DevLaTron/sd2snes/pcb/kicad/RevK/fpga.sch

## KiCad design pcb/kicad/RevK/fpga.sch (2018-12-27)

Schematic: fpga.sch

Parts:
C201, C202, C203, C204, C205, C206, C207, C208, C209, C210, C211, C212, C213, C214, C215, C221, C222, C223, C224, C231, C232, C233, C234: 100n; SM0805_FIXEDMASK
P113: CONN_1; PAD_1x1mm
U201: XC3S400-PQ208; PQFP208_ALTPADS

Notes on the sheet:
FPGA
SNES A+B bus
70ns PSRAM bus
45ns SRAM bus
SD bus; shared with MCU
SPI (MCU interface)
DAC
JTAG
