DevLaTron/sd2snes/pcb/kicad/RevK/pwr_misc.sch

## KiCad design pcb/kicad/RevK/pwr_misc.sch (2018-12-27)

Schematic: pwr_misc.sch

Parts:
BT351: Keystone 1059 / KZH20PCB; BT_KEYSTONE_1059_20MM
C301, C303, C304, C311, C312, C321, C322: 4.7u; SM0805_FIXEDMASK
C302: 10n; SM0805_FIXEDMASK
C331, C341, C343: 100n; SM0805_FIXEDMASK
C332, C333: 100p; SM0805_FIXEDMASK
C342: 1u; SM0805_FIXEDMASK
C344, C345: 10u; SM0805_FIXEDMASK
C391: 100u; SM1210L
FB341: FILTER; SM0805_FIXEDMASK
JP341: FB 0603; SolderJumper-2_P1.3mm_Open_Pad1.0x1.5mm
L301, L302: 1uH; SM1210L; PartNo LQH32PN1R0NN0L
L391: 10uH; SM1210L
Q301: IRLML6402PbF; SOT-23
R230, R231: 10; SM0805_FIXEDMASK
R301: 20k; SM0805_FIXEDMASK
R331, R332, R333: 680; SM0805_FIXEDMASK
U230: TS9222; TSSOP-8_4.4x3mm_P0.65mm
U301: MIC23250-S4YMT; QFN10-2x2
U311: MCP1824-1802E/OT; SOT23-5_LARGEPADS
U321: MCP1824-2502E/OT; SOT23-5_LARGEPADS
U331: PIC12F629-I/P; DIP-8_W7.62mm
U341: CS4344; TSSOP10

Notes on the sheet:
Stuff with 0603 ferrite bead
Power, DAC, CIC, Batt
inverse polarity protection
Battery (SRAM + RTC)
2.5V LDO
1.8V LDO
3.3V + 1.2V Step-Down
Audio DAC
Power Supply
SuperCIC Key
