DevLaTron/sd2snes/pcb/kicad/RevK/snesslot.sch

## KiCad design pcb/kicad/RevK/snesslot.sch (2019-01-02, an earlier design)

Schematic: snesslot.sch

Parts:
C101, C102, C103, C104, C105, C106, C111, C112, C113, C114, C115, C116: 100n; SM0805_FIXEDMASK
C121, C122, C123, C124, C125, C126, C127, C128: 10p; SM0805_FIXEDMASK
J101: SNESCART_EXT
Q101: 2N2222A; SOT-23-EBC
R101: 270; SM0805_FIXEDMASK
R102: 100k; SM0805_FIXEDMASK
R103: 4k7; SM0805_FIXEDMASK
RA101, RA102, RA105, RA106, RA107, RA108, RA109, RA110, RA111, RA112, RA113, RA114: 100; R_PACK_1206_2
RA103, RA104: FB; R_PACK_1206_2
U101, U102, U103: 74ALVC164245DGG; TSSOP48

Notes on the sheet:
SNES bus, level shift
