DevLaTron/sd2snes/pcb/kicad/RevK/rescue-backup/pwr_misc-2018-12-25-14-31-40.sch

## KiCad design pcb/kicad/RevK/rescue-backup/pwr_misc-2018-12-25-14-31-40.sch (2018-12-25)

Schematic: pwr_misc-2018-12-25-14-31-40.sch

Parts:
BT351: Keystone 1059 / KZH20PCB; BT_KEYSTONE_1059_20MM
C301, C303, C304, C311, C312, C321, C322: 4.7u; SM0805_FIXEDMASK
C302, C347, C349: 10n; SM0805_FIXEDMASK
C331, C341, C343: 100n; SM0805_FIXEDMASK
C332, C333: 100p; SM0805_FIXEDMASK
C342: 1u; SM0805_FIXEDMASK
C344, C345: 10u; SM0805_FIXEDMASK
C346, C348: 3.3u; SM0805_FIXEDMASK
C391: 100u
FB341: FILTER
JP341: FB 0603
L301, L302: 1uH; SM1210L; PartNo LQH32PN1R0NN0L
L391: 10uH
Q301: IRLML6402PbF
R301: 20k; SM0805_FIXEDMASK
R331, R332, R333: 680; SM0805_FIXEDMASK
R341, R343: 470; SM0805_FIXEDMASK
R342, R344: 10k; SM0805_FIXEDMASK
U301: MIC23250-S4YMT; QFN10-2x2
U311: MCP1824-1802E/OT; SOT23-5
U321: MCP1824-2502E/OT; SOT23-5
U331: PIC12F629-I/P; SO8N
U341: CS4344; TSSOP10

Notes on the sheet:
Stuff with 0603 ferrite bead
Power, DAC, CIC, Batt
inverse polarity protection
Battery (SRAM + RTC)
2.5V LDO
1.8V LDO
3.3V + 1.2V Step-Down
Audio DAC
Power Supply
SuperCIC Key
