DevLaTron/sd2snes/verilog/sd2snes_gsu/ipcore_dir/gsu_fmult.v

////////////////////////////////////////////////////////////////////////////////
// Copyright (c) 1995-2013 Xilinx, Inc.  All rights reserved.
////////////////////////////////////////////////////////////////////////////////
//   ____  ____
//  /   /\/   /
// /___/  \  /    Vendor: Xilinx
// \   \   \/     Version: P.20131013
//  \   \         Application: netgen
//  /   /         Filename: gsu_fmult.v
// /___/   /\     Timestamp: Thu Jun 07 01:15:08 2018
// \   \  /  \ 
//  \___\/\___\
//             
// Command	: -w -sim -ofmt verilog D:/prj/sd2snes/verilog/sd2snes_gsu/ipcore_dir/tmp/_cg/gsu_fmult.ngc D:/prj/sd2snes/verilog/sd2snes_gsu/ipcore_dir/tmp/_cg/gsu_fmult.v 
// Device	: 3s400pq208-4
// Input file	: D:/prj/sd2snes/verilog/sd2snes_gsu/ipcore_dir/tmp/_cg/gsu_fmult.ngc
// Output file	: D:/prj/sd2snes/verilog/sd2snes_gsu/ipcore_dir/tmp/_cg/gsu_fmult.v
// # of Modules	: 1
// Design Name	: gsu_fmult
// Xilinx        : E:\Xilinx\14.7\ISE_DS\ISE\
//             
// Purpose:    
//     This verilog netlist is a verification model and uses simulation 
//     primitives which may not represent the true implementation of the 
//     device, however the netlist is functionally correct and should not 
//     be modified. This file cannot be synthesized and should only be used 
//     with supported simulation tools.
//             
// Reference:  
//     Command Line Tools User Guide, Chapter 23 and Synthesis and Simulation Design Guide, Chapter 6
//             
////////////////////////////////////////////////////////////////////////////////

`timescale 1 ns/1 ps

module gsu_fmult (
  clk, p, a, b
)/* synthesis syn_black_box syn_noprune=1 */;
  input clk;
  output [31 : 0] p;
  input [15 : 0] a;
  input [15 : 0] b;
  
  // synthesis translate_off
  
  wire \blk00000001/sig00000043 ;
  wire \blk00000001/sig00000042 ;
  wire \blk00000001/sig00000041 ;
  wire \blk00000001/sig00000040 ;
  wire \blk00000001/sig0000003f ;
  wire \blk00000001/sig0000003e ;
  wire \blk00000001/sig0000003d ;
  wire \blk00000001/sig0000003c ;
  wire \blk00000001/sig0000003b ;
  wire \blk00000001/sig0000003a ;
  wire \blk00000001/sig00000039 ;
  wire \blk00000001/sig00000038 ;
  wire \blk00000001/sig00000037 ;
  wire \blk00000001/sig00000036 ;
  wire \blk00000001/sig00000035 ;
  wire \blk00000001/sig00000034 ;
  wire \blk00000001/sig00000033 ;
  wire \blk00000001/sig00000032 ;
  wire \blk00000001/sig00000031 ;
  wire \blk00000001/sig00000030 ;
  wire \blk00000001/sig0000002f ;
  wire \blk00000001/sig0000002e ;
  wire \blk00000001/sig0000002d ;
  wire \blk00000001/sig0000002c ;
  wire \blk00000001/sig0000002b ;
  wire \blk00000001/sig0000002a ;
  wire \blk00000001/sig00000029 ;
  wire \blk00000001/sig00000028 ;
  wire \blk00000001/sig00000027 ;
  wire \blk00000001/sig00000026 ;
  wire \blk00000001/sig00000025 ;
  wire \blk00000001/sig00000024 ;
  wire \blk00000001/sig00000023 ;
  wire \blk00000001/sig00000022 ;
  wire \NLW_blk00000001/blk00000004_P<34>_UNCONNECTED ;
  wire \NLW_blk00000001/blk00000004_P<33>_UNCONNECTED ;
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
    .R(\blk00000001/sig00000022 ),
    .A({a[15], a[15], a[15], a[14], a[13], a[12], a[11], a[10], a[9], a[8], a[7], a[6], a[5], a[4], a[3], a[2], a[1], a[0]}),
    .B({b[15], b[15], b[15], b[14], b[13], b[12], b[11], b[10], b[9], b[8], b[7], b[6], b[5], b[4], b[3], b[2], b[1], b[0]}),
    .P({\blk00000001/sig0000003c , \NLW_blk00000001/blk00000004_P<34>_UNCONNECTED , \NLW_blk00000001/blk00000004_P<33>_UNCONNECTED , 
\NLW_blk00000001/blk00000004_P<32>_UNCONNECTED , \NLW_blk00000001/blk00000004_P<31>_UNCONNECTED , \blk00000001/sig0000003b , \blk00000001/sig00000039 
, \blk00000001/sig00000038 , \blk00000001/sig00000037 , \blk00000001/sig00000036 , \blk00000001/sig00000035 , \blk00000001/sig00000034 , 
\blk00000001/sig00000033 , \blk00000001/sig00000032 , \blk00000001/sig00000031 , \blk00000001/sig00000030 , \blk00000001/sig0000002e , 
\blk00000001/sig0000002d , \blk00000001/sig0000002c , \blk00000001/sig0000002b , \blk00000001/sig0000002a , \blk00000001/sig00000029 , 
\blk00000001/sig00000028 , \blk00000001/sig00000027 , \blk00000001/sig00000026 , \blk00000001/sig00000025 , \blk00000001/sig00000043 , 
\blk00000001/sig00000042 , \blk00000001/sig00000041 , \blk00000001/sig00000040 , \blk00000001/sig0000003f , \blk00000001/sig0000003e , 
\blk00000001/sig0000003d , \blk00000001/sig0000003a , \blk00000001/sig0000002f , \blk00000001/sig00000024 })
  );
  VCC   \blk00000001/blk00000003  (
    .P(\blk00000001/sig00000023 )
  );
  GND   \blk00000001/blk00000002  (
    .G(\blk00000001/sig00000022 )
  );

// synthesis translate_on

endmodule

// synthesis translate_off

`ifndef GLBL
`define GLBL

`timescale  1 ps / 1 ps

module glbl ();

    parameter ROC_WIDTH = 100000;
    parameter TOC_WIDTH = 0;

//--------   STARTUP Globals --------------
    wire GSR;
    wire GTS;
    wire GWE;
    wire PRLD;
    tri1 p_up_tmp;
    tri (weak1, strong0) PLL_LOCKG = p_up_tmp;

    wire PROGB_GLBL;
    wire CCLKO_GLBL;

    reg GSR_int;
    reg GTS_int;
    reg PRLD_int;

//--------   JTAG Globals --------------
    wire JTAG_TDO_GLBL;
    wire JTAG_TCK_GLBL;
    wire JTAG_TDI_GLBL;
    wire JTAG_TMS_GLBL;
    wire JTAG_TRST_GLBL;

    reg JTAG_CAPTURE_GLBL;
    reg JTAG_RESET_GLBL;
    reg JTAG_SHIFT_GLBL;
    reg JTAG_UPDATE_GLBL;
    reg JTAG_RUNTEST_GLBL;

    reg JTAG_SEL1_GLBL = 0;
    reg JTAG_SEL2_GLBL = 0 ;
    reg JTAG_SEL3_GLBL = 0;
    reg JTAG_SEL4_GLBL = 0;

    reg JTAG_USER_TDO1_GLBL = 1'bz;
    reg JTAG_USER_TDO2_GLBL = 1'bz;
    reg JTAG_USER_TDO3_GLBL = 1'bz;
    reg JTAG_USER_TDO4_GLBL = 1'bz;

    assign (weak1, weak0) GSR = GSR_int;
    assign (weak1, weak0) GTS = GTS_int;
    assign (weak1, weak0) PRLD = PRLD_int;

    initial begin
	GSR_int = 1'b1;
	PRLD_int = 1'b1;
	#(ROC_WIDTH)
	GSR_int = 1'b0;
	PRLD_int = 1'b0;
    end

    initial begin
	GTS_int = 1'b1;
	#(TOC_WIDTH)
	GTS_int = 1'b0;
    end

endmodule

`endif

// synthesis translate_on
