DevLaTron/sd2snes/verilog/sd2snes_sdd1/Input_Manager.vhd

----------------------------------------------------------------------------------
-- Company: Traducciones Magno
-- Engineer: Magno
--
-- Create Date: 18.03.2018 18:59:09
-- Design Name:
-- Module Name: Input_Manager - Behavioral
-- Project Name:
-- Target Devices:
-- Tool Versions:
-- Description:
--
-- Dependencies:
--
-- Revision:
-- Revision 0.01 - File Created
-- Additional Comments:
--
----------------------------------------------------------------------------------


library IEEE;
use IEEE.STD_LOGIC_1164.ALL;
use IEEE.STD_LOGIC_ARITH.ALL;
use IEEE.STD_LOGIC_UNSIGNED.ALL;

-- Uncomment the following library declaration if using
-- arithmetic functions with Signed or Unsigned values
use IEEE.NUMERIC_STD.ALL;

-- Uncomment the following library declaration if instantiating
-- any Xilinx leaf cells in this code.
--library UNISIM;
--use UNISIM.VComponents.all;

entity Input_Manager is
	Port(	clk 									: in 	STD_LOGIC;
			-- control data
			DMA_Conf_Valid						: in	STD_LOGIC;
			DMA_In_Progress					: in	STD_LOGIC;
			Header_Valid						: out	STD_LOGIC;
			Header_BPP							: out	STD_LOGIC_VECTOR(1 downto 0);
			Header_Context						: out	STD_LOGIC_VECTOR(1 downto 0);
			-- data input from ROM
			ROM_Data_tready 					: out STD_LOGIC;
			ROM_Data_tvalid					: in 	STD_LOGIC;
			ROM_Data_tdata						: in 	STD_LOGIC_VECTOR(15 downto 0);
			ROM_Data_tkeep						: in 	STD_LOGIC_VECTOR(1 downto 0);
			-- Golomb decoded value
			Decoded_Bit_tready				: in 	STD_LOGIC;
			Decoded_Bit_tuser					: in 	STD_LOGIC_VECTOR(7 downto 0);
			Decoded_Bit_tvalid				: out STD_LOGIC;
			Decoded_Bit_tdata					: out STD_LOGIC;
			Decoded_Bit_tlast					: out STD_LOGIC );
end Input_Manager;


architecture Behavioral of Input_Manager is

	COMPONENT FIFO_AXIS
		Generic( FIFO_DEPTH						: integer := 32 );
		Port(	clk									: IN 	STD_LOGIC;
				srst 									: IN 	STD_LOGIC;
				din_tready							: OUT	STD_LOGIC;
				din_tvalid							: IN 	STD_LOGIC;
				din_tdata 							: IN 	STD_LOGIC_VECTOR(15 DOWNTO 0);
				din_tkeep							: IN	STD_LOGIC_VECTOR(1 downto 0);
				dout_tready							: IN 	STD_LOGIC;
				dout_tvalid							: OUT STD_LOGIC;
				dout_tdata							: OUT STD_LOGIC_VECTOR(7 DOWNTO 0);
				full									: OUT STD_LOGIC;
				empty									: OUT STD_LOGIC );
	END COMPONENT;
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
