DevLaTron/sd2snes/(commit log)

2018-12-25 Add RevK WIP
    [fpga-2018-12-24-11-23-46.sch, fpga.sch, mcu-2018-12-24-11-23-46.sch, mcu.sch, memory-2018-12-24-11-23-46.sch, memory.sch, pwr_misc-2018-12-24-11-23-46.sch, pwr_misc.sch]
2018-12-25 Update positions and layouts to make more sense
    [fpga-2018-12-25-14-31-40.sch, mcu-2018-12-25-14-31-40.sch, memory-2018-12-25-14-31-40.sch, pwr_misc-2018-12-25-14-31-40.sch, sd2snes-2018-12-25-14-31-40.sch, sd2snes.kicad_pcb, snesslot-2018-12-25-14-31-40.sch]
2018-12-25 Update paths, fix OpAmp stuff
    [pwr_misc.sch, sd2snes.kicad_pcb]
2018-12-25 Refill zones
    [sd2snes.kicad_pcb]
2018-12-25 Fix connector
    [sd2snes.kicad_pcb]
2018-12-25 Add gnd to pin 28 of U401
    [mcu.sch, sd2snes.kicad_pcb]
2018-12-26 Update misc layouts, match PCB and schematic footprinting
    [fpga.sch, mcu.sch, memory.sch, pwr_misc.sch, sd2snes.kicad_pcb, sd2snes.sch, snesslot.sch]
2018-12-26 Minor fixes in layout
    [memory.sch, sd2snes.kicad_pcb, snesslot.sch]
2018-12-26 Update Layout for Resistor Arrays
    [fpga.sch, mcu.sch, memory.sch, pwr_misc.sch, sd2snes.kicad_pcb, sd2snes.sch, snesslot.sch]
2018-12-26 Fix Design Check stuff
    [sd2snes.kicad_pcb]
2018-12-27 Add upgraded Footprints Libraries
    [fpga.sch, pwr_misc.sch, sd2snes.kicad_pcb]
2018-12-27 Fix trace bug
    [sd2snes.kicad_pcb]
2018-12-27 Fix routing issues with Q501, Q101, some close tracks to pins
    [sd2snes.kicad_pcb]
2018-12-27 Fix tracing again, fixing other stuff in Schema
    [sd2snes.kicad_pcb]
2018-12-27 Change N2222A footprint to EBC as per original schematic
    [memory.sch, sd2snes.kicad_pcb, snesslot.sch]
2018-12-27 Fix OpAmp orientation
    [pwr_misc.sch, sd2snes.kicad_pcb]
2018-12-27 Fixes for Transistor placement
    [sd2snes.kicad_pcb]
2018-12-27 Fix stupid layout mistake
    [pwr_misc.sch, sd2snes.kicad_pcb]
2018-12-27 - Reroute to use small SD card slot
    [sd2snes.kicad_pcb]
2018-12-27 More changes on Micro SD card connector
    [mcu.sch, sd2snes.kicad_pcb]
2018-12-27 small routing fixes
    [sd2snes.kicad_pcb]
2019-01-01 Add BOM and boardview schematic for assembly assistance
    [sd2snes_bom_K.csv, sd2snes_rev_k.brd]
2019-01-02 - Cleanup of Annotations for FB arrays - Cleanup of Silkscreen designators for assembly
    [sd2snes.kicad_pcb, snesslot.sch]
2019-01-02 - Switch to UBS-Type B Micro connector
    [mcu.sch, sd2snes.kicad_pcb]
2019-02-25 - Update footprint to have enough "notches"
2019-02-25 - Update Edge cuts
    [sd2snes.kicad_pcb]
2019-02-26 - Minor trace cleanups
    [sd2snes.kicad_pcb]
2019-02-26 - Update planes
    [sd2snes.kicad_pcb]
2019-02-26 - Fixed PCB description text - Added bragging rights
    [sd2snes.kicad_pcb]
2019-02-27 -Edge cut fixes. Thanks to Brazil!
2019-02-27 - Add Interactive BOM file - Fix outlines in PCB
    [sd2snes.kicad_pcb]
