DevLaTron/sd2snes/(notices)

Notices in the files:
pcb/kicad/RevK/sd2snes.kicad_pcb:
©2009 - 2019 ikari_01
